AmokCrow/UHERobot/RobotControlBoardHW/RobotControlBoard.brd

## EAGLE design RobotControlBoardHW/RobotControlBoard.brd (2016-02-22)

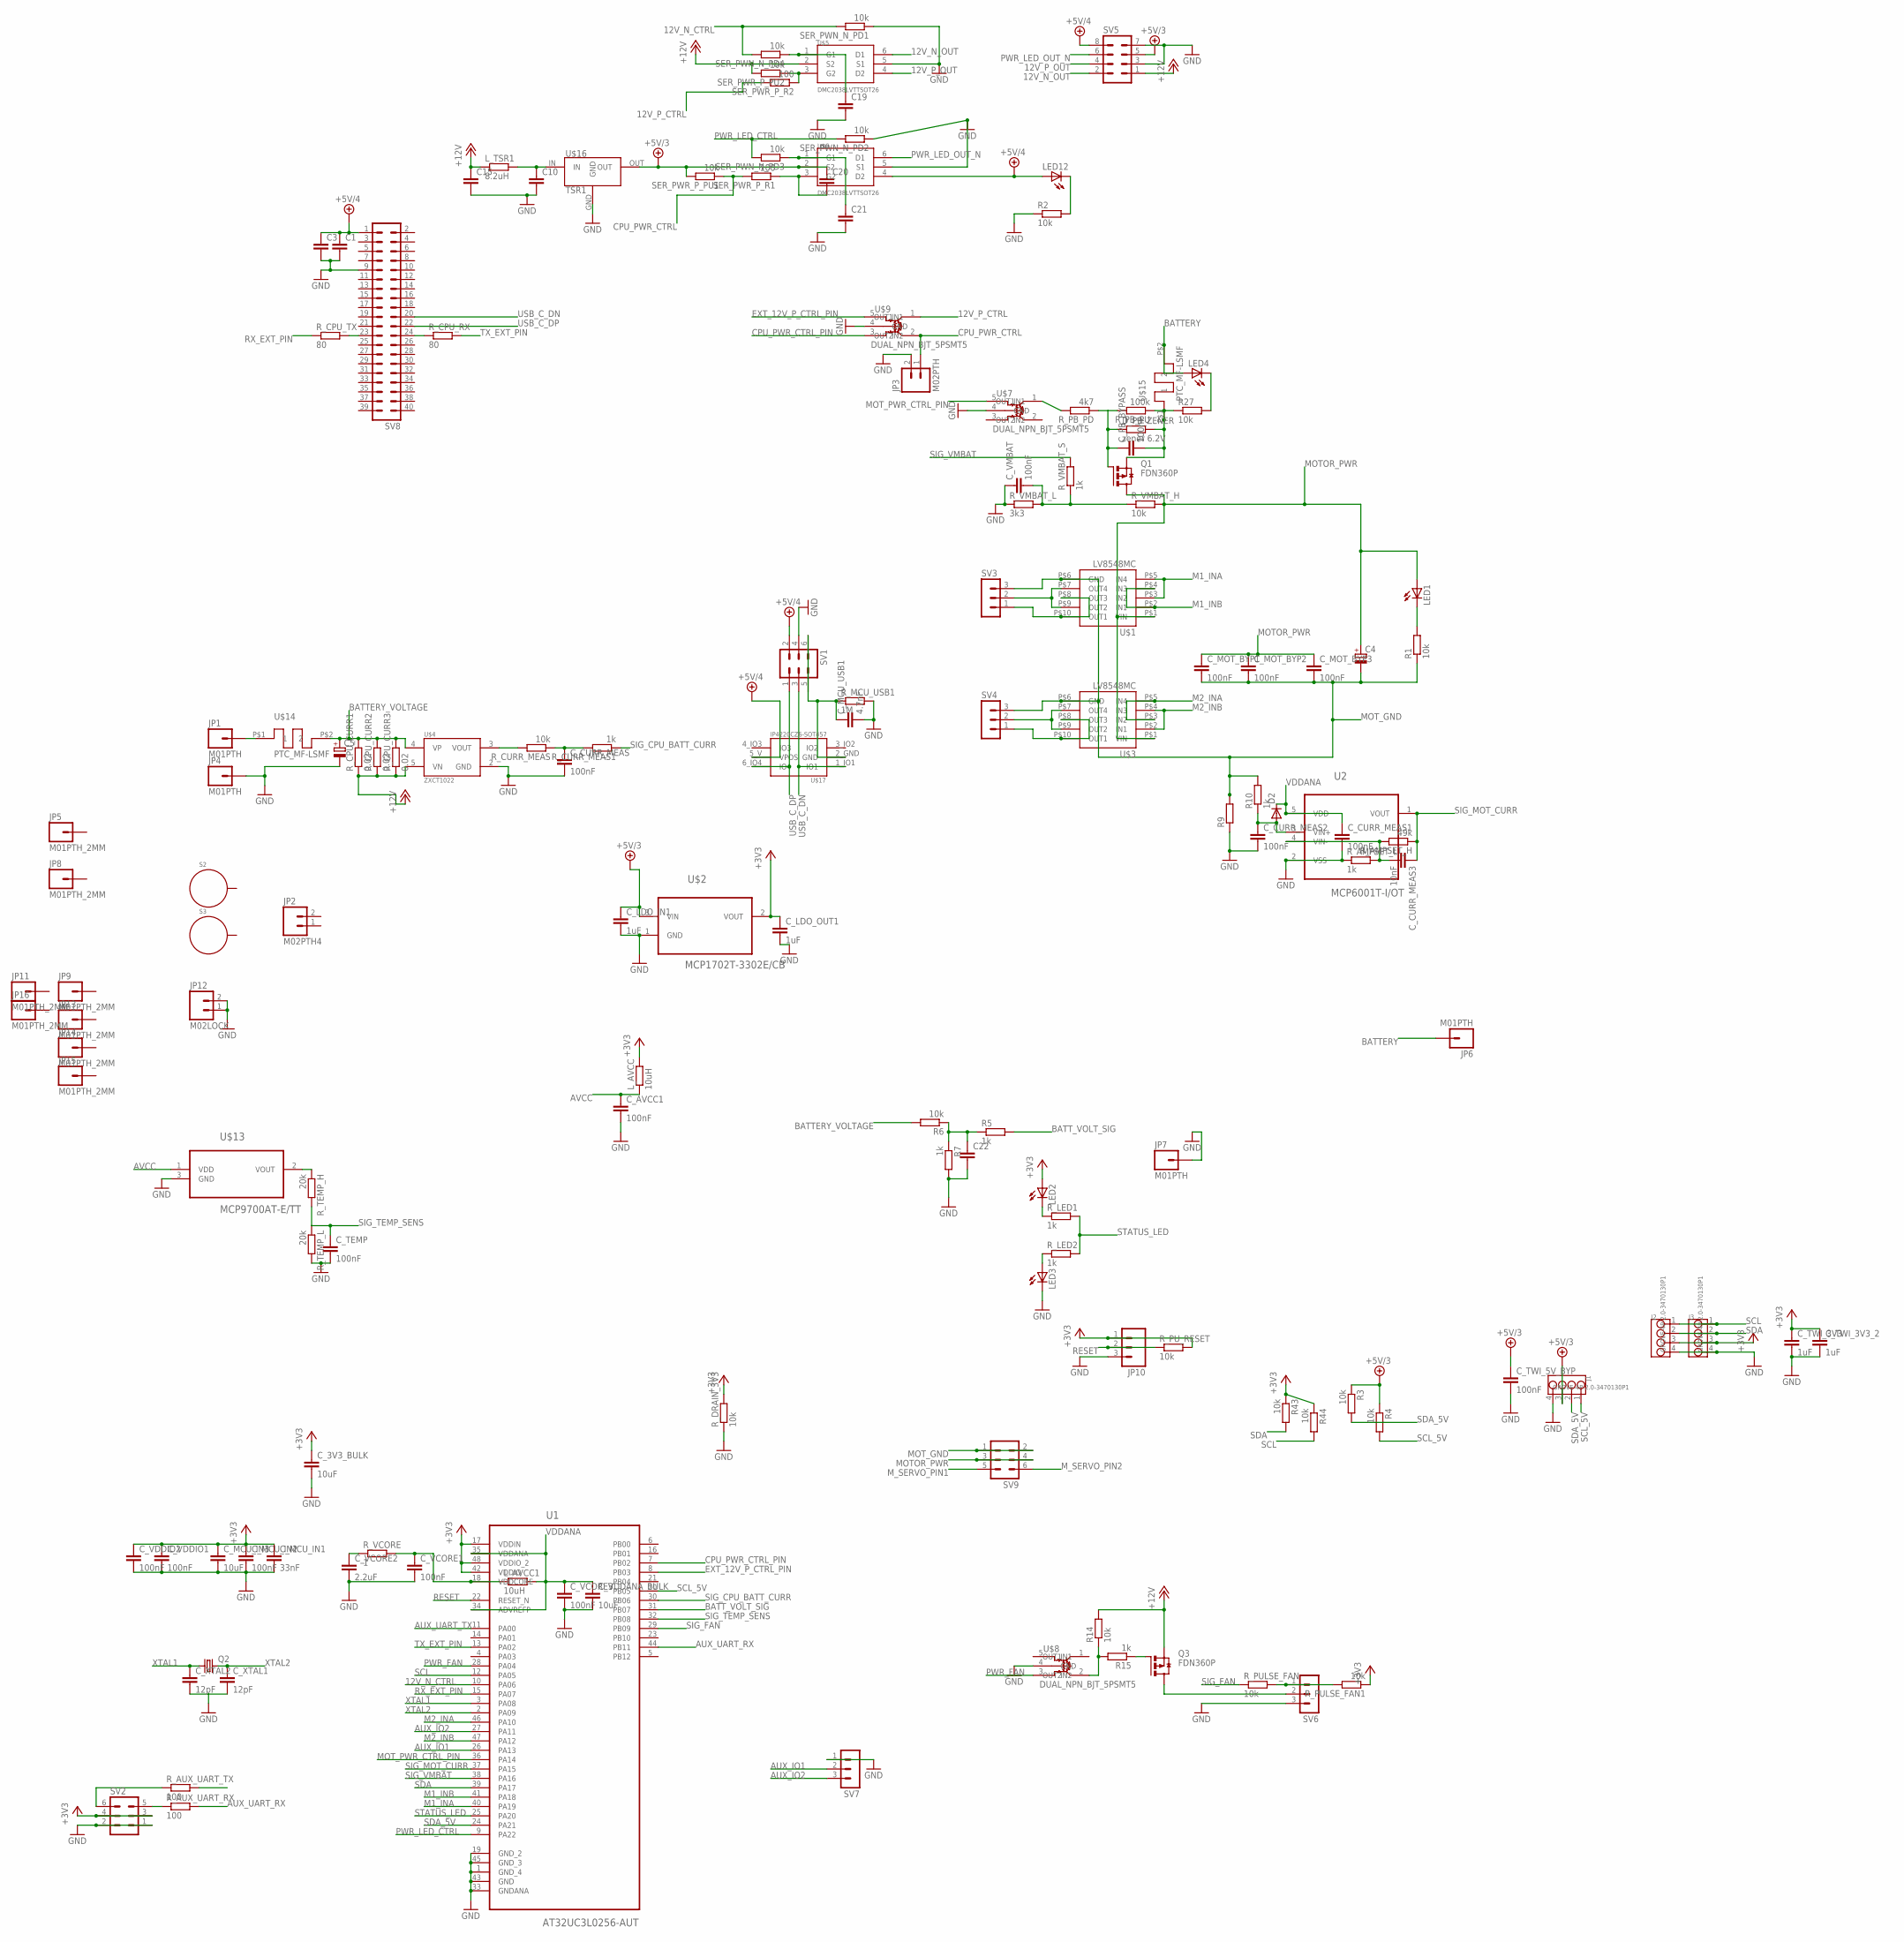
[picture p1: schematic RobotControlBoard.sch]

Parts:
C1, C3: C-EUC1210K; C1210K
C4: CPOL-EUE3.5-8; E3,5-8
C5: CPOL-EUE2.5-6; E2,5-6
C10, C15: C-EUC0805; C0805
C19, C20, C21, C22: C-EUC0603K; C0603K
C_3V3_BULK: 10uF; C1206
C_AVCC1: 100nF; C0603
C_CURR_MEAS, C_CURR_MEAS1, C_CURR_MEAS2: 100nF; C0603K
C_CURR_MEAS3: 10nF; C0603K
C_LDO_IN1: 1uF; C0805
C_LDO_OUT1: 1uF; C0805
C_MCU_IN1: 33nF; C0603K
C_MCU_IN2: 100nF; C0603K
C_MCU_IN3: 10uF; C0805
C_MCU_USB1: 4.7nF; C0603
C_MOT_BYP1, C_MOT_BYP2, C_MOT_BYP3: 100nF; C0603K
C_PB_BYPASS: 100nF; C0603K
C_TEMP: 100nF; C0603
C_TWI_3V3, C_TWI_3V3_2: 1uF; C0805K
C_TWI_5V_BYP: 100nF; C0603K
C_VCORE1, C_VCORE3: 100nF; C0603K
C_VCORE2: 2.2uF; C0805
C_VDDANA_BULK: 10uF; C0805
C_VDDIO1, C_VDDIO2: 100nF; C0603K
C_VMBAT: 100nF; C0603K
C_XTAL1, C_XTAL2: 12pF; C0603K
D2: DIODE-SOD323-W; SOD323-W
D_PB_ZENER: zener 6.2V; R0805W
J1, J2, J3: GROVE-4P-2.0-3470130P1; 4P-2.0
JP1, JP4, JP6, JP7: M01PTH; 1X01
JP2: M02PTH4; 1X02_XTRA_BIG
JP3: M02PTH; 1X02
JP5, JP8, JP9, JP11, JP13, JP14, JP15, JP16: M01PTH_2MM; 1X01_2MM
JP10: M03PTH; 1X03
JP12: M02LOCK; 1X02_LOCK
LED1, LED2, LED3, LED4, LED12: LEDSML0603; SML0603
L_AVCC: 10uH; R0603
L_AVCC1: 10uH; R0805
L_TSR1: 8.2uH; M0805
Q1, Q3: FDN360P; SUPER-SOT3
Q2: CRYSTALHC49S; HC49/S
R1, R2, R3, R4, R6, R14, R27, R43, R44: 10k; R0603
R5, R7, R10, R15: 1k; R0603
R9: R-EU_M1206; M1206
R_AMPSET_H: 49k; R0603
R_AMPSET_L: 1k; R0603
R_AUX_UART_RX: 100; R0603
R_AUX_UART_TX: 100; R0603
R_CPU_CURR1, R_CPU_CURR2, R_CPU_CURR3: 0.02; R0805
R_CPU_RX: 80; R0603
R_CPU_TX: 80; R0603
R_CURR_MEAS: 10k; R0603
R_CURR_MEAS1: 1k; R0603
R_DRAIN_3V3: 10k; R0603
R_LED1, R_LED2: 1k; R0603
R_MCU_USB1: 1M; R0603
R_PB_PD: 4k7; R0603
R_PB_PU: 100k; R0603
R_PULSE_FAN, R_PULSE_FAN1: 10k; R0603
R_PU_RESET: 10k; R0603
R_TEMP_H: 20k; R0603
R_TEMP_L: 20k; R0603
R_VCORE: 1; R0603
R_VMBAT_H: 10k; R0603
R_VMBAT_L: 3k3; R0603
R_VMBAT_S: 1k; R0603
S2, S3: STANDOFF_ELECTRICAL; STANDOFF-ELECTRICAL
SER_PWN_N_PD1, SER_PWN_N_PD2, SER_PWN_N_PD3, SER_PWN_N_PD4: 10k; R0603
SER_PWR_P_PU1, SER_PWR_P_PU2: 10k; R0603
SER_PWR_P_R1, SER_PWR_P_R2: 100; R0603
SV1, SV2, SV9: MA03-2
SV3, SV4, SV6, SV7: MA03-1
SV5: MA04-2
SV8: MA20-2
U1: AT32UC3L0256-AUT; QFP50P900X900X120-48N
U2: MCP6001T-I/OT; SOT95P270X145-5N
U$1, U$3: LV8548MC; SOIC10
U$2: MCP1702T-3302E/CB; SOT95P255X145-3N
U$4: ZXCT1022; SOT23-5
U$5, U$6: DMC2038LVTTSOT26; TSOT26
U$7, U$8, U$9: DUAL_NPN_BJT_5PSMT5; SC-74A
U$13: MCP9700AT-E/TT; SOT95P237X112-3N
U$14, U$15: PTC_MF-LSMF; PTC_FUSE_BOURNS
U$16: TSR1; TSR-1
U$17: IP4220CZ6-SOT457; SOT457_NXP_ESD

Connections:
12V_N_CTRL: SER_PWN_N_PD1.2, SER_PWN_N_PD4.2, U1.10 (PA06)
12V_N_OUT: SV5.2, U$5.6 (D1)
12V_P_CTRL: SER_PWR_P_R2.2, U$9.1 (OUT1)
12V_P_OUT: SV5.4, U$5.4 (D2)
+3V3: C_3V3_BULK.1, C_LDO_OUT1.1, C_MCU_IN1.1, C_MCU_IN2.1, C_MCU_IN3.1, C_TWI_3V3.1, C_TWI_3V3_2.1, C_VDDIO1.1, C_VDDIO2.1, J2.3, J3.3, JP10.1, LED2.A, L_AVCC.2, R43.1, R44.1, R_DRAIN_3V3.2, R_PULSE_FAN1.1, R_PU_RESET.2, SV2.3, SV2.4, U1.17 (VDDIN), U1.42 (VDDIO), U1.48 (VDDIO_2), U$2.2 (VOUT)
+5V/3: C20.1, C_LDO_IN1.1, C_TWI_5V_BYP.1, J1.3, R3.1, R4.1, SER_PWR_P_PU1.2, SV5.5, U$2.3 (VIN), U$6.2 (S2), U$16.OUT
+5V/4: C1.1, C3.1, LED12.A, SV1.2, SV5.8, SV8.1, U$6.4 (D2), U$17.5_V (VPOS)
+12V: C15.1, L_TSR1.1, Q3.2 (S), R14.2, R_CPU_CURR1.1, R_CPU_CURR2.1, R_CPU_CURR3.1, SER_PWR_P_PU2.2, SV5.1, U$4.5 (VN), U$5.2 (S2)
AUX_IO1: SV7.2, U1.26 (PA13)
AUX_IO2: SV7.3, U1.27 (PA11)
AUX_UART_RX: R_AUX_UART_RX.2, U1.44 (PB11)
AUX_UART_TX: R_AUX_UART_TX.2, U1.11 (PA00)
AVCC: C_AVCC1.1, L_AVCC.1, U$13.1 (VDD)
BATTERY: JP6.1, LED4.A, U$15.P$2 (2)
BATTERY_VOLTAGE: C5.+, R6.2, R_CPU_CURR1.2, R_CPU_CURR2.2, R_CPU_CURR3.2, U$4.4 (VP), U$14.P$2 (2)
BATT_VOLT_SIG: R5.2, U1.31 (PB07)
BATT_VOLT_SIG_N: C22.1, R5.1, R6.1, R7.1
CPU_PWR_CTRL: JP3.1, SER_PWR_P_PU1.1, SER_PWR_P_R1.2, U$9.2 (OUT2)
CPU_PWR_CTRL_PIN: U1.7 (PB02), U$9.3 (IN2)
EXT_12V_P_CTRL_PIN: U1.8 (PB03), U$9.5 (IN1)
GND: C1.2, C3.2, C5.-, C10.2, C15.2, C19.2, C21.2, C22.2, C_3V3_BULK.2, C_AVCC1.2, C_CURR_MEAS.2, C_CURR_MEAS1.2, C_CURR_MEAS2.2, C_LDO_IN1.2, C_LDO_OUT1.2, C_MCU_IN1.2, C_MCU_IN2.2, C_MCU_IN3.2, C_MCU_USB1.2, C_TEMP.2, C_TWI_3V3.2, C_TWI_3V3_2.2, C_TWI_5V_BYP.2, C_VCORE1.2, C_VCORE2.2, C_VCORE3.2, C_VDDANA_BULK.2, C_VDDIO1.2, C_VDDIO2.2, C_VMBAT.1, C_XTAL1.2, C_XTAL2.2, J1.4, J2.4, J3.4, JP3.2, JP4.1, JP7.1, JP10.3, JP12.1, JP12.2, LED3.C, R2.1, R7.2, R9.1, R_AMPSET_L.1, R_DRAIN_3V3.1, R_MCU_USB1.2, R_TEMP_L.2, R_VMBAT_L.1, SER_PWN_N_PD1.1, SER_PWN_N_PD2.1, SV1.4, SV2.1, SV2.2, SV5.3, SV5.7, SV6.3, SV7.1, SV8.9, U1.1 (GND_4), U1.19 (GND_2), U1.33 (GNDANA), U1.43 (GND), U1.45 (GND_3), U2.2 (VSS), U$2.1 (GND), U$4.2 (GND), U$5.5 (S1), U$6.5 (S1), U$7.4 (GND), U$8.4 (GND), U$9.4 (GND), U$13.3 (GND), U$16.GND
M1_INA: U1.40 (PA19), U$1.P$3 (IN2), U$1.P$5 (IN4)
M1_INB: U1.41 (PA18), U$1.P$2 (IN1), U$1.P$4 (IN3)
M2_INA: U1.46 (PA10), U$3.P$3 (IN2), U$3.P$5 (IN4)
M2_INB: U1.47 (PA12), U$3.P$2 (IN1), U$3.P$4 (IN3)
MOTOR_PWR: C4.+, C_MOT_BYP1.1, C_MOT_BYP2.1, C_MOT_BYP3.1, LED1.A, Q1.3 (D), R_VMBAT_H.2, SV9.3, SV9.4, U$1.P$1 (VIN), U$3.P$1 (VIN)
MOT_GND: C4.-, C_MOT_BYP1.2, C_MOT_BYP2.2, C_MOT_BYP3.2, R1.1, R9.2, R10.2, SV3.3, SV4.3, SV9.1, SV9.2, U$1.P$6 (GND), U$3.P$6 (GND)
MOT_PWR_CTRL_PIN: U1.36 (PA14), U$7.5 (IN1)
M_SERVO_PIN1: SV9.5
M_SERVO_PIN2: SV9.6
unnamed: R_AUX_UART_RX.1, SV2.5
unnamed: LED3.A, R_LED2.1
unnamed: LED2.C, R_LED1.1
unnamed: R_CURR_MEAS.2, U$4.3 (VOUT)
unnamed: C_VMBAT.2, R_VMBAT_H.1, R_VMBAT_L.2, R_VMBAT_S.1
unnamed: JP1.1, U$14.P$1 (1)
unnamed: C_VCORE2.1, R_VCORE.1
unnamed: C20.2, SER_PWR_P_R1.1, U$6.3 (G2)
unnamed: SV3.1, U$1.P$8 (OUT3), U$1.P$10 (OUT1)
unnamed: C19.1, SER_PWN_N_PD4.1, U$5.1 (G1)
unnamed: SV3.2, U$1.P$7 (OUT4), U$1.P$9 (OUT2)
unnamed: C_PB_BYPASS.2, D_PB_ZENER.2, Q1.2 (S), R27.1, R_PB_PU.1, U$15.P$1 (1)
unnamed: SER_PWR_P_PU2.1, SER_PWR_P_R2.1, U$5.3 (G2)
unnamed: R_AUX_UART_TX.1, SV2.6
unnamed: C_PB_BYPASS.1, D_PB_ZENER.1, Q1.1 (G), R_PB_PD.1, R_PB_PU.2
unnamed: R_TEMP_H.1, U$13.2 (VOUT)
unnamed: R_PB_PD.2, U$7.1 (OUT1)
unnamed: LED1.C, R1.2
unnamed: SV4.2, U$3.P$7 (OUT4), U$3.P$9 (OUT2)
unnamed: SV4.1, U$3.P$8 (OUT3), U$3.P$10 (OUT1)
unnamed: C_VCORE1.1, L_AVCC1.1, R_VCORE.2, U1.18 (VDDCORE)
unnamed: C10.1, L_TSR1.2, U$16.IN
unnamed: C_CURR_MEAS2.1, D2.A, R10.1, U2.3 (VIN+)
unnamed: C_CURR_MEAS3.2, R_AMPSET_H.2, R_AMPSET_L.2, U2.4 (VIN-)
unnamed: LED4.C, R27.2
unnamed: R_CPU_RX.1, SV8.24
unnamed: R_CPU_TX.2, SV8.23
unnamed: C_MCU_USB1.1, R_MCU_USB1.1, SV1.5, SV1.6, U$17.2_GND (GND)
unnamed: Q3.1 (G), R15.1
unnamed: R14.1, R15.2, U$8.2 (OUT2)
unnamed: Q3.3 (D), SV6.2
unnamed: R_PULSE_FAN.2, R_PULSE_FAN1.2, SV6.1
unnamed: C21.1, SER_PWN_N_PD3.1, U$6.1 (G1)
unnamed: LED12.C, R2.2
PWR_FAN: U1.28 (PA04), U$8.3 (IN2)
PWR_LED_CTRL: SER_PWN_N_PD2.2, SER_PWN_N_PD3.2, U1.9 (PA22)
PWR_LED_OUT_N: SV5.6, U$6.6 (D1)
RESET: JP10.2, R_PU_RESET.1, U1.22 (RESET_N)
RX_EXT_PIN: R_CPU_TX.1, U1.15 (PA07)
SCL: J2.1, J3.1, R44.2, U1.12 (PA05)
SCL_5V: J1.1, R4.2, U1.20 (PB05)
SDA: J2.2, J3.2, R43.2, U1.39 (PA17)
SDA_5V: J1.2, R3.2, U1.24 (PA21)
SIG_CPU_BATT_CURR: R_CURR_MEAS1.1, U1.30 (PB06)
SIG_CPU_BATT_CURRENT_N: C_CURR_MEAS.1, R_CURR_MEAS.1, R_CURR_MEAS1.2
SIG_FAN: R_PULSE_FAN.1, U1.29 (PB09)
SIG_MOT_CURR: C_CURR_MEAS3.1, R_AMPSET_H.1, U1.37 (PA15), U2.1 (VOUT)
SIG_TEMP_SENS: C_TEMP.1, R_TEMP_H.2, R_TEMP_L.1, U1.32 (PB08)
SIG_VMBAT: R_VMBAT_S.2, U1.38 (PA16)
STATUS_LED: R_LED1.2, R_LED2.2, U1.25 (PA20)
TX_EXT_PIN: R_CPU_RX.2, U1.13 (PA02)
USB_C_DN: SV1.3, SV8.20, U$17.1_IO1 (IO1)
USB_C_DP: SV1.1, SV8.22, U$17.6_IO4 (IO4)
VDDANA: C_CURR_MEAS1.1, C_VCORE3.1, C_VDDANA_BULK.1, D2.C, L_AVCC1.2, U1.34 (ADVREFP), U1.35 (VDDANA), U2.5 (VDD)
XTAL1: C_XTAL2.1, Q2.1, U1.3 (PA08)
XTAL2: C_XTAL1.1, Q2.2, U1.2 (PA09)

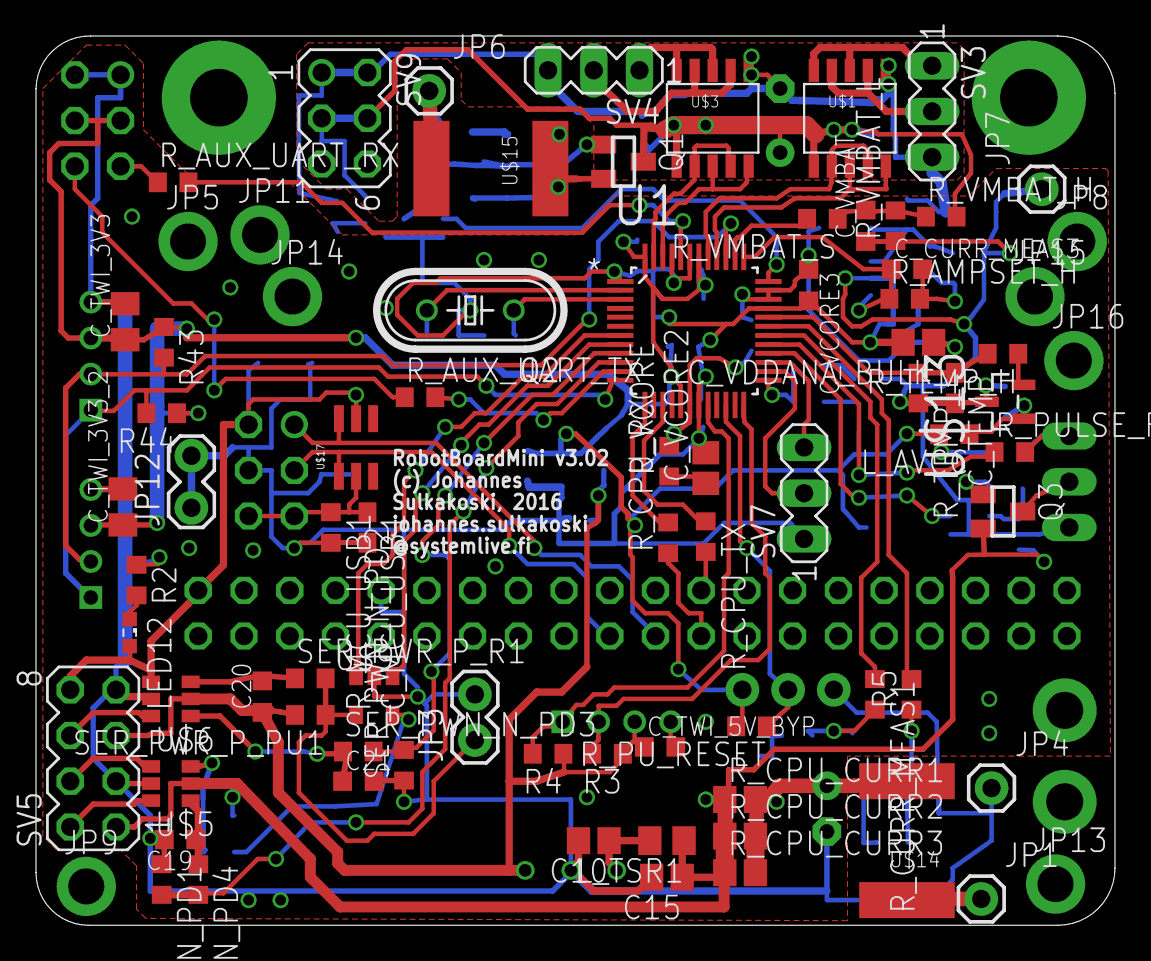
[picture p2: board RobotControlBoard.brd from above]

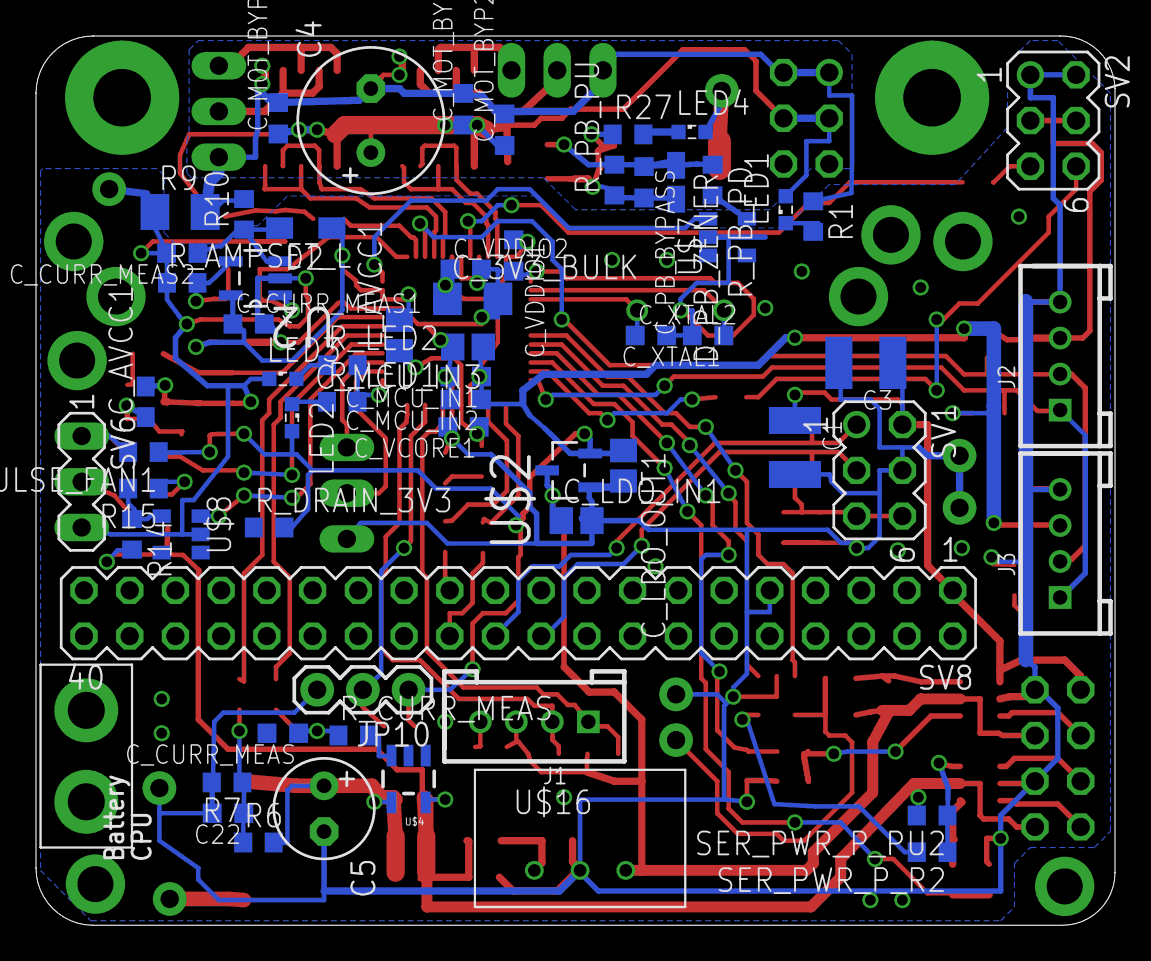
[picture p3: board RobotControlBoard.brd from below]

Board: 4 copper layers, 59.9 x 49.4 mm, 146 parts (64 on the bottom side), 84 nets.
