AmokCrow/UHERobot/RobotControlDaemon/base16message.cpp

#include "base16message.h"

#include <cstring>
#include <string>
#include <iostream>

Base16Message::Base16Message()
    : mNumBytesUnencoded(0)
    , mNumBytesEncoded(0)
    , mIsEncoded(false)
    , mIsDecoded(false)
    , mHasData(false)
{

}


const char* Base16Message::encodedBytesPtr()
{
    if(mIsEncoded)
    {
        return (const char*)mEncodedBuff;
    }
    else if(mIsDecoded)
    {
        encode();
        return (const char* const)mEncodedBuff;
    }
    else
    {
        return NULL;
    }
}

const char* Base16Message::decodedBytesPtr()
{
    if(mIsDecoded)
    {
        return (const char*)mUnencodedBuff;
    }
    else if(mIsEncoded)
    {
        decode();
        return (const char*)mUnencodedBuff;
    }
    else
    {
        return NULL;
    }
}

int Base16Message::encodedLength()
{
    return mNumBytesEncoded;
}

int Base16Message::decodedLength()
{
    return mNumBytesUnencoded;
}

bool Base16Message::isValid()
{
    if(mIsEncoded || mIsDecoded)
    {
        return true;
    }

    return false;
}

bool Base16Message::setBody(const char * const msg, int msgLen)
{
    if(msgLen > UHEROBOT_BOARD_MSG_MAX_LEN_BYTES)
    {
        classyError("Too long payload");
    }

    memcpy(mUnencodedBuff, msg, msgLen);

    mHasData = true;
    mNumBytesUnencoded = msgLen;

    mIsDecoded = true;

    return isValid();
}

Base16Message::eMsgStates Base16Message::feedRawMsgByte(char rawByte)
{
    // There was already a message here. Clear it and continue receiving.
    if(mIsEncoded)
    {
        clear();
    }

    // End of message. Try to decode it.
    if(rawByte == '\n')
    {
        putByteToRawBuff(rawByte);

        if(decode())
        {
            return FINISHED;
        }
        else
        {
            classyError("Could not decode message properly");
            clear();
            return MSG_ERR;
        }
    }
    // Beginning of a message. Clear buffer.
    else if(rawByte == 'b')
    {
        clear();
        putByteToRawBuff(rawByte);
        return CONTINUE;
    }
    // Allow endline characters between messages
    else if(rawByte == '\r')
    {
        return CONTINUE;
    }
    else if(((rawByte >= '0') && (rawByte <= '9')) || ((rawByte >= 'A') && (rawByte <= 'F')))
    {
        if(mNumBytesEncoded >= MAX_BUFF_SIZE - 2)
        {
            classyError("Buffer full");
            clear();
            return MSG_ERR;
        }

        if(mEncodedBuff[0] != 'b')
        {
            classyError("Badly formed message");
            clear();
            return MSG_ERR;
        }

        putByteToRawBuff(rawByte);
        return CONTINUE;
    }
    else
    {
        classyError("Bad character: Not Base16");
        clear();
        return MSG_ERR;
    }
}

void Base16Message::classyError(const char* const msg)
{
    std::cout << "Base16Message: Error: " << msg << std::endl;
}

// The buffBytes argument referred to is updated to contain the number of bytes
//  not handled before either a message was completed, an error encountered or
//  the buffer was consumed. The return value will tell which one of these happened.
Base16Message::eMsgStates Base16Message::feedRawMsgBuff(const char* rawBuff, int& buffBytes)
{
    int buffPos = 0;
    eMsgStates lastState = CONTINUE;

    while((lastState == CONTINUE) && (buffBytes > 0))
    {
        lastState = feedRawMsgByte(rawBuff[buffPos]);
        buffPos++;
        buffBytes--;
    }

    return lastState;
}

bool Base16Message::encode()
{
    // Check if there is anything to encode
    if(mIsDecoded == false)
    {
        return false;
    }

    mNumBytesEncoded = 1;
    mEncodedBuff[0] = 'b';

    for(int i = 0; i < mNumBytesUnencoded; i++)
    {
        byteToB16(mUnencodedBuff[i], &(mEncodedBuff[mNumBytesEncoded]));
        mNumBytesEncoded += 2;
    }

    mEncodedBuff[mNumBytesEncoded] = '\n';
    mEncodedBuff[mNumBytesEncoded + 1] = 0;

    mNumBytesEncoded++;

    return true;
}

bool Base16Message::decode()
{
    for(int i = 0; i < mNumBytesEncoded; i++)
    {
        std::cout << mEncodedBuff[i] << '(' << (int)mEncodedBuff[i] << ") ";
    }
    std::cout << std::endl;

    // The number of characters in the buffer should be 2n + 4, where n is the number of payload bytes.
    if((mNumBytesEncoded % 2) != 0)
    {
        classyError("Odd number of half-bytes in a message");
        clear();
        return false;
    }

    if(mNumBytesEncoded < 2)
    {
        classyError("Too few half-bytes in a message");
        clear();
        return false;
    }

    // start from beginning of message body and hop per Base16 pair
    int rawPos = 1;
    int dataPos = 0;
    while(rawPos < mNumBytesEncoded)
    {
        mUnencodedBuff[dataPos] = B16ToByte(&(mEncodedBuff[rawPos]));
        rawPos += 2;
        dataPos++;
    }

    if(dataPos != 0)
    {
        mHasData = true;
    }

    mIsEncoded = true;
    mIsDecoded = true;

    mNumBytesUnencoded = dataPos - 1;

    return true;
}

void Base16Message::putByteToRawBuff(char ch)
{
    // This check should be unnecessary, but we all know how that goes...
    if(mNumBytesEncoded >= MAX_BUFF_SIZE)
    {
        classyError("Buffer overflow in pushing bytes in to buffer");
        clear();
        return;
    }

    mEncodedBuff[mNumBytesEncoded] = ch;
    mNumBytesEncoded++;
}

void Base16Message::byteToB16(char src, char* dest)
{
    char tmp = ((src & 0xF0) >> 4);

    if(tmp < 10)
    {
        tmp += '0';
    }
    else
    {
        tmp += 'A' - 10;
    }

    dest[0] = tmp;

    tmp = src & 0x0F;

    if(tmp < 10)
    {
        tmp += '0';
    }
    else
    {
        tmp += 'A' - 10;
    }

    dest[1] = tmp;
}

char Base16Message::B16ToByte(const char * const src)
{
    char returnables[2];

    for(int i = 0; i < 2; i++)
    {
        char tmp = src[i];

        if((tmp >= '0') && (tmp <= '9'))
        {
            tmp -= '0';
        }
        else
        {
            tmp += 10;
            tmp -= 'A';
        }

        returnables[i] = tmp;
    }

    return (returnables[0] << 4) | returnables[1];
}

void Base16Message::clear()
{
    mNumBytesUnencoded = 0;
    mNumBytesEncoded = 0;
    mIsEncoded = false;
    mIsDecoded = false;
    mHasData = false;
}
