AmokCrow/UHERobot/RobotControlDaemon/DataExchangeStructures.h

#ifndef DATAEXCHANGESTRUCTURES_H
#define DATAEXCHANGESTRUCTURES_H

namespace JsWebUtils
{

struct DExGeneralParam
{
    const char* prefix;
    float value;
    const char* suffix;
    const char* apiMarker;
};

} // JSWebUtils

#endif // DATAEXCHANGESTRUCTURES_H
