AmokCrow/UHERobot/(commit log)

2014-02-10 Only encoding and sending missing from UART side. And threading..
    [MessageParser.cpp, MessageParser.h]
2014-04-26 Just in case
2014-04-30 Changed FcgiServer to use pthread library, due to a bug in Raspbian c++11 libraries.
    [ControlLogic.cpp, MessageParser.cpp, MessageParser.h]
2014-05-03 Motor control via web works. Needs cleaning though.
2014-07-28 Added new board code
2014-10-13 Servo4017 mostly finished. Main changed from C to CPP file extension.
2014-11-07 Added Servo4017 final and MotorControl initial.
2014-11-27 Finished code to get both motors moving. Plus debug commands.
2014-11-28 Finished debug stats printing with selfmade functions.
2014-11-29 Changed server to main thread communication method
2014-12-17 Fixed a JSON bug.
    [ControlLogic.cpp]
2014-12-19 Debugged communication board to daemon.
2014-12-19 Debugged the other end of the board to daemon communications.
2015-03-14 Added hardware files.
    [RB1_v2.GBL, RB1_v2.GBO, RB1_v2.GBP, RB1_v2.GBS, RB1_v2.GTL, RB1_v2.GTO, RB1_v2.GTP, RB1_v2.GTS]
2015-03-21 Changed control UART to correct port.
    [main.cpp]
2015-06-20 Board control SW work.
2015-06-27 Got the new board to give stats to Daemon and Fcgi.
2015-07-04 Tightened the control loop.
    [ControlLogic.cpp, ControlLogic.h]
2015-07-04 Board changes to get robot to function.
2015-07-05 Added servo code to robot board.
2015-07-06 Added camera and shutdown scripts.
2015-07-07 Copied RobotBoard4 schematic and layout from schemas repo for publishing.
    [RobotBoard4.brd, RobotBoard4.sch]
2015-07-18 Small refinements of the HTML interface and camera script.
2015-08-28 Moved pin mappings and ADC of RobotBoard4 to the new board revision 4.2 .
2015-08-29 Redressed the protocol used to report adc results from RobotBoard4.2
2015-09-22 Fix in index.html . Redid the ADC readings handling to be more uniform.
    [robotboard2interpreter.cpp, robotboard2interpreter.h]
2015-12-19 Minor fixes and adaptations.
    [main.c]
2016-02-06 Enabled power to motors and CPU in the board control code.
2016-02-07 Motors now move correctly. Whenever the rx interrupts get processed soon enough anyways.
    [Motors.c, main.c]
2016-02-13 Added analogs scaling to MCU. Now the Linux SW only does data propagation. Less specific to this one board, etc..
2016-02-22 Removed obsolete folders.
    [RB1_v2.GBL, RB1_v2.GBO, RB1_v2.GBP, RB1_v2.GBS, RB1_v2.GTL, RB1_v2.GTO, RB1_v2.GTP, RB1_v2.GTS]
2016-02-22 Copied over new HW files.
    [RobotControlBoard.brd, RobotControlBoard.sch]
